ShageeshanT/easycliq/components/MAX485-TTL-to-RS485-Module_front.jpeg

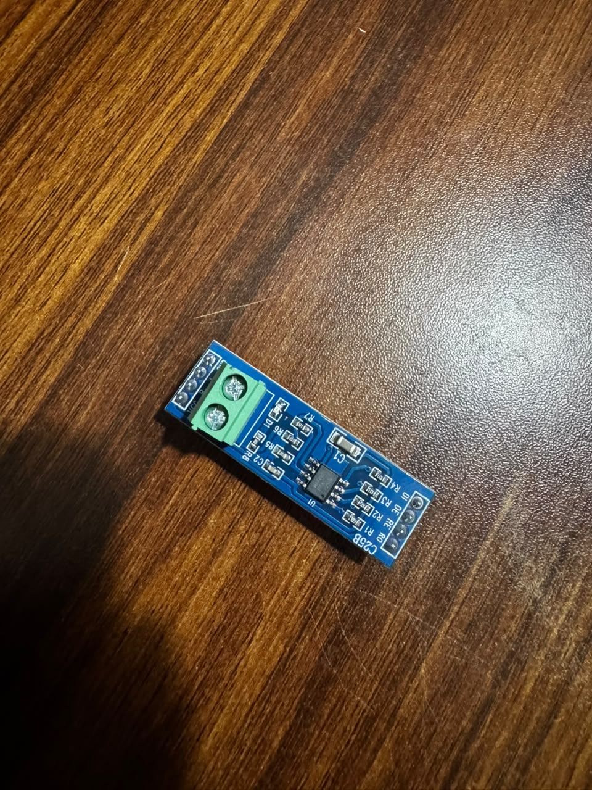
components/MAX485-TTL-to-RS485-Module_front.jpeg
