ShageeshanT/easycliq/components/Micro-Limit-Switch-Roller-Lever-x2_and_Screw-Terminal-5.08mm-2pin-x2.jpeg

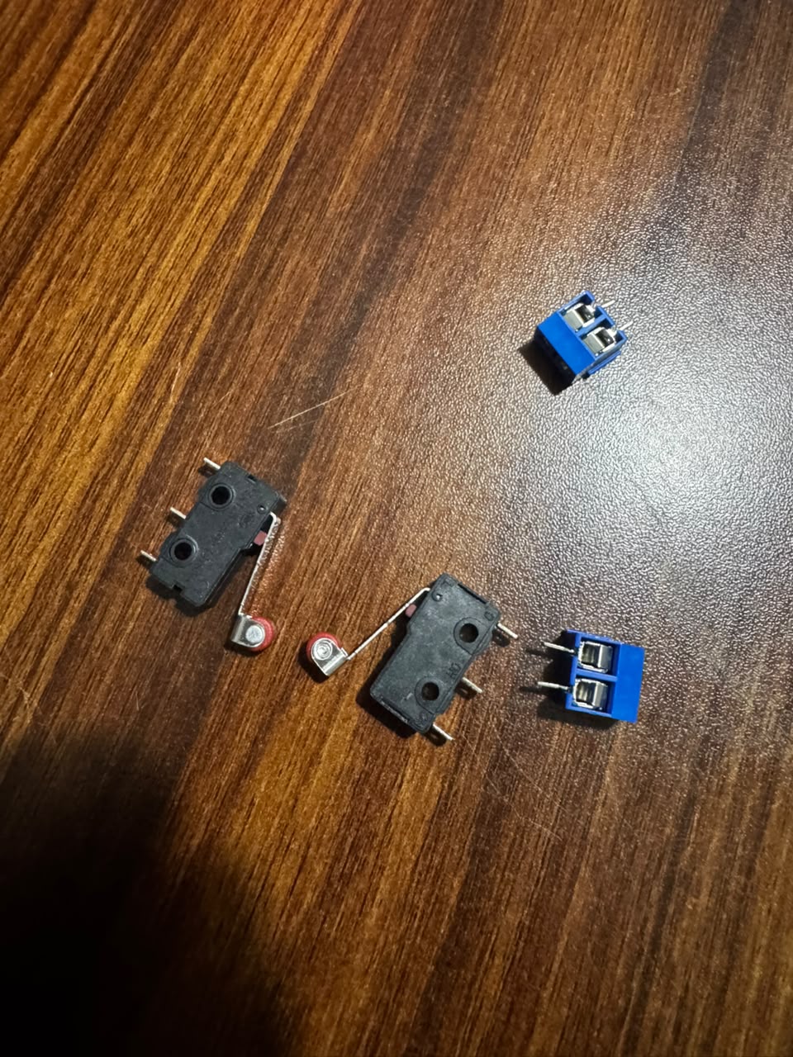
components/Micro-Limit-Switch-Roller-Lever-x2_and_Screw-Terminal-5.08mm-2pin-x2.jpeg
