ShageeshanT/easycliq/EasyCliq-Buy-List.pdf

E A S Y C L I Q · S T A G E 1

# Buy list

Just enough to get all three motors spinning.
Skytronic, Kohuwala · prices from tronic.lk, 24 Sep 2026
ITEM | CODE | QTY | RS
830-point breadboard (MB-102) | TA0036 | 1 | 250
100 µF 50 V electrolytic capacitor | CA0122 | 5 | 25
4.7 kΩ resistor pack (~40 pcs) | RP0043 | 1 | 50
10 kΩ resistor pack (~40 pcs) | RP0047 | 1 | 50
Total | | | 375

ONLY IF YOU DON'T ALREADY HAVE ONE
DT830D multimeter | TA0077 | 1 | 830
Computer power cord 13A | TA1235 | 1 | 720

Everything else waits until the three motors spin and the build is verified.
