ShageeshanT/easycliq/components/AHT20-AM2301B-Temp-Humidity-Sensor_box.jpeg

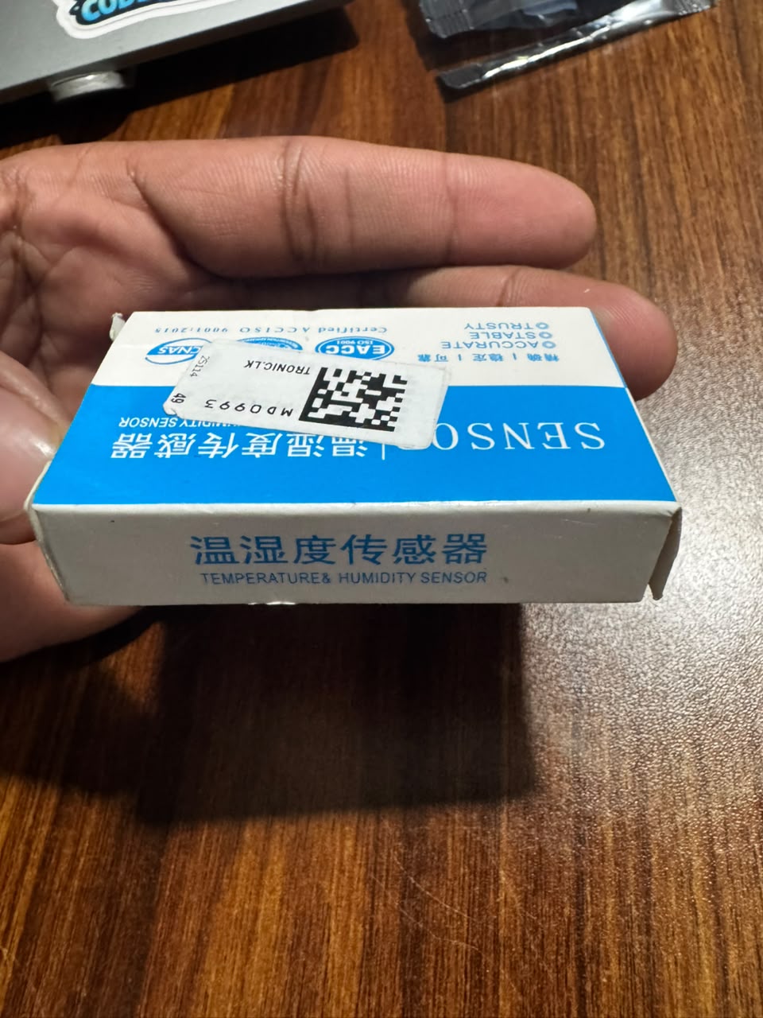
components/AHT20-AM2301B-Temp-Humidity-Sensor_box.jpeg
