ShageeshanT/easycliq/components/Breadboard-400-Tiepoint_packaged.jpeg

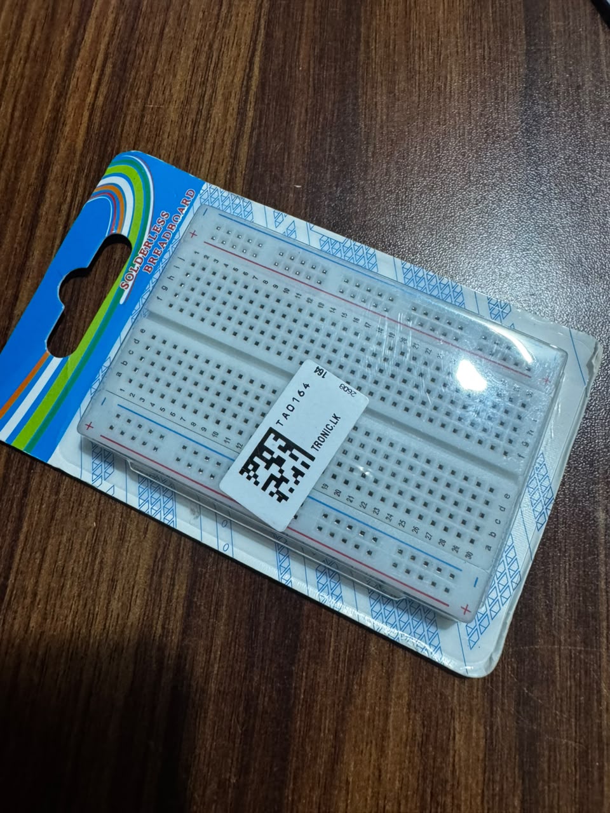
components/Breadboard-400-Tiepoint_packaged.jpeg
