ShageeshanT/easycliq/components/DRV8825-Stepper-Driver_back-pin-labels_with-heatsink.jpeg

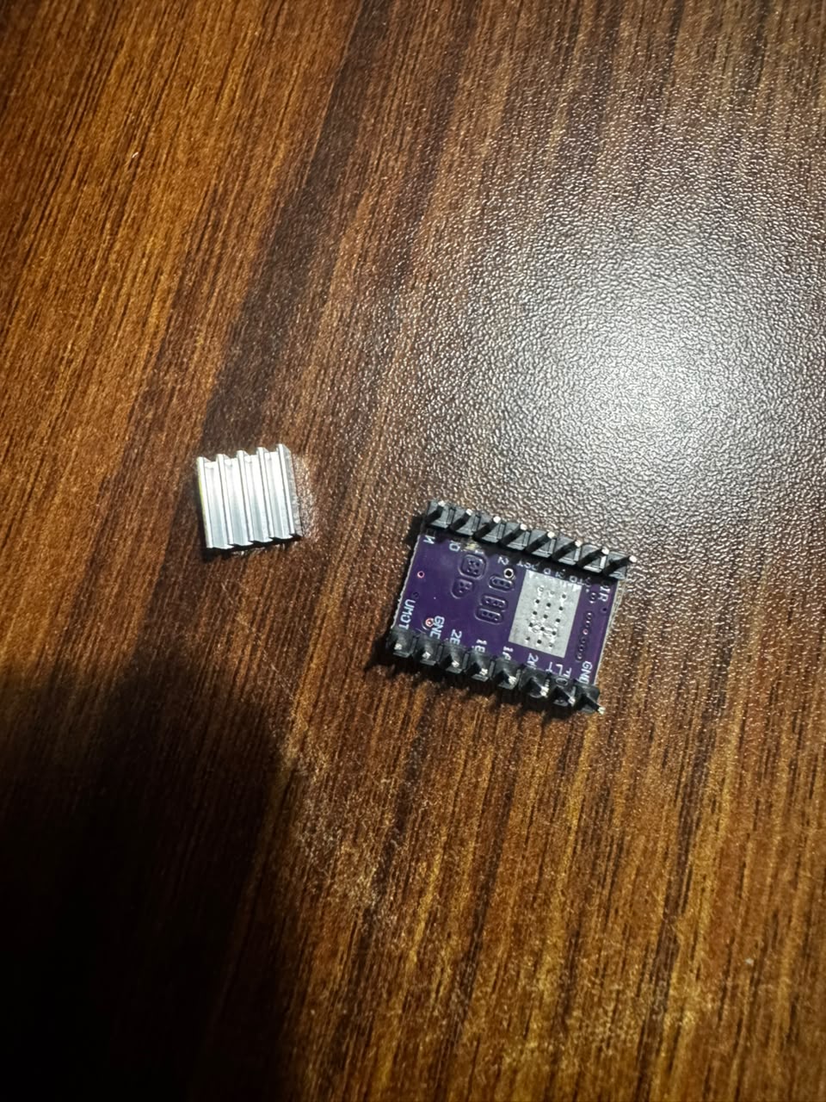
components/DRV8825-Stepper-Driver_back-pin-labels_with-heatsink.jpeg
