ShageeshanT/easycliq/components/DRV8825-Stepper-Driver_front-chip-side_with-heatsink.jpeg

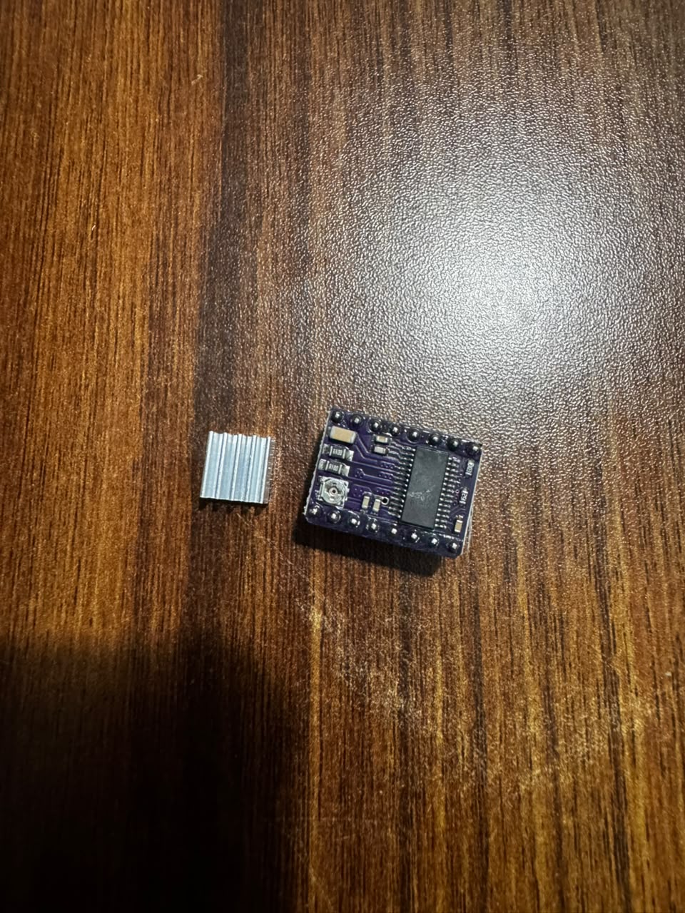
components/DRV8825-Stepper-Driver_front-chip-side_with-heatsink.jpeg
