ShageeshanT/easycliq/components/ESP32-DevKit-30pin-CP2102_front_2.jpeg

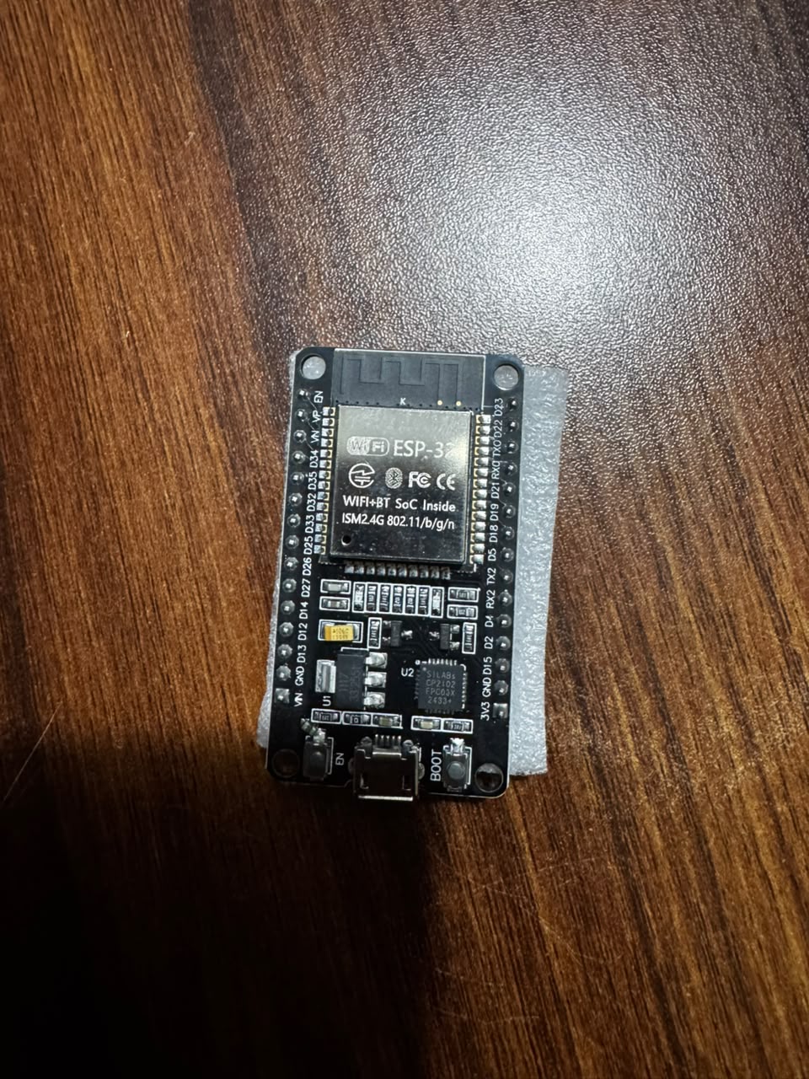
components/ESP32-DevKit-30pin-CP2102_front_2.jpeg
