ShageeshanT/easycliq/components/IRF520-MOSFET-Module-Keyes_front.jpeg

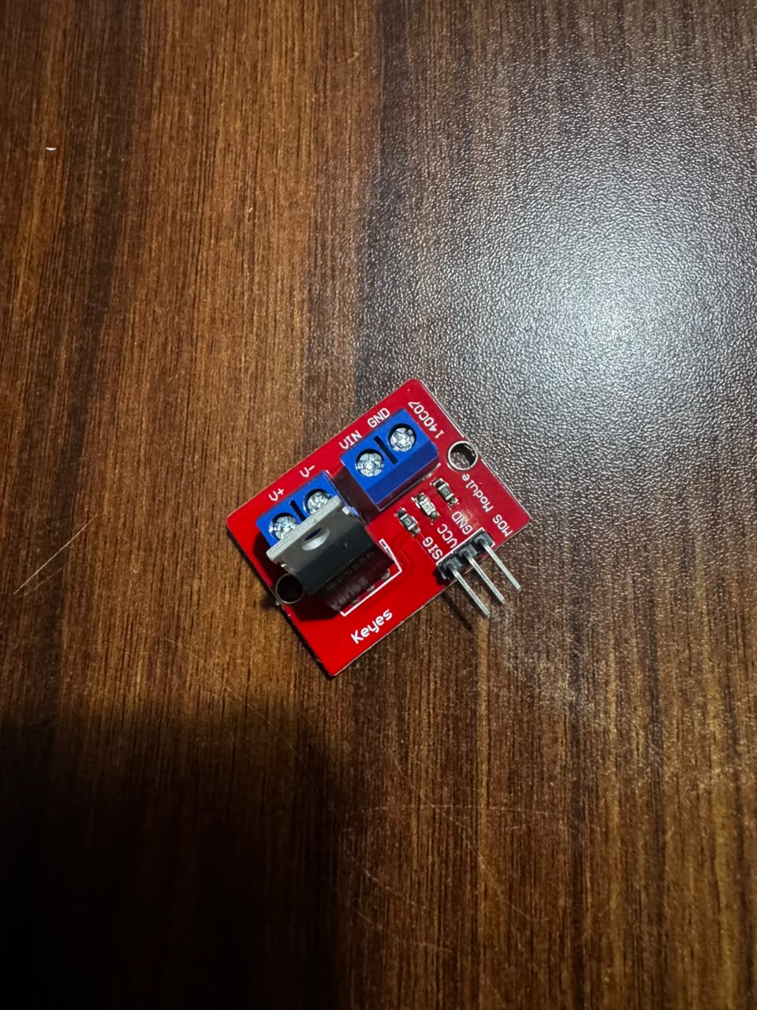
components/IRF520-MOSFET-Module-Keyes_front.jpeg
