ShageeshanT/easycliq/components/LM2596-Buck-Converter-HW-411_back.jpeg

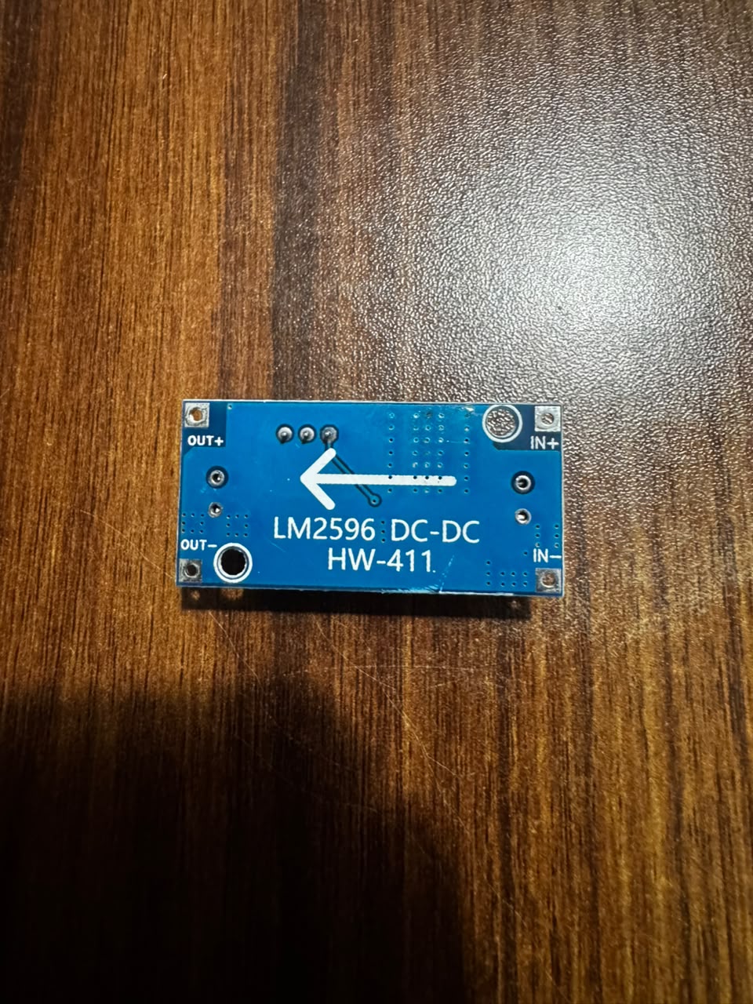
components/LM2596-Buck-Converter-HW-411_back.jpeg
