ShageeshanT/easycliq/components/LM2596-Buck-Converter-HW-411_front.jpeg

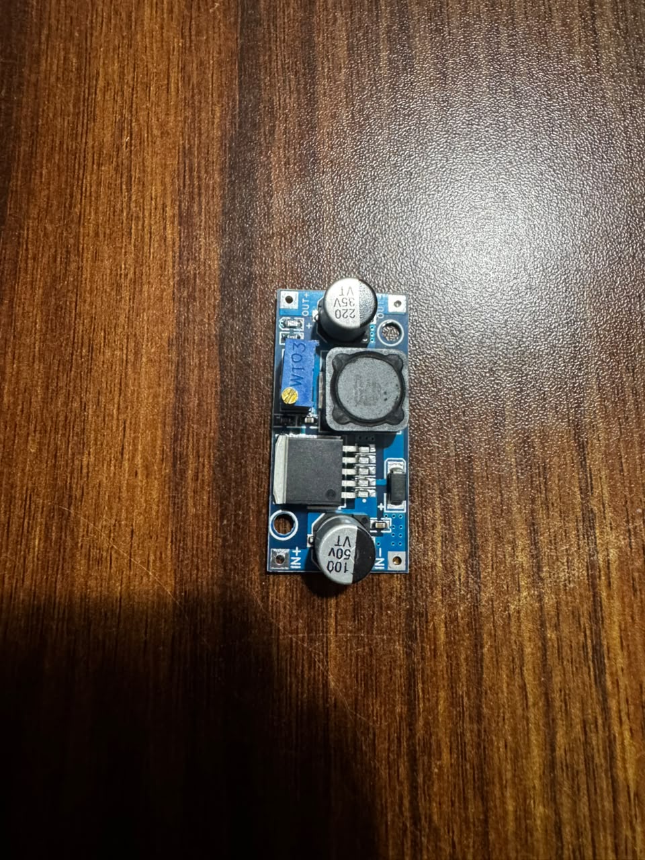
components/LM2596-Buck-Converter-HW-411_front.jpeg
