ShageeshanT/easycliq/components/MAX485-TTL-to-RS485-Module_back.jpeg

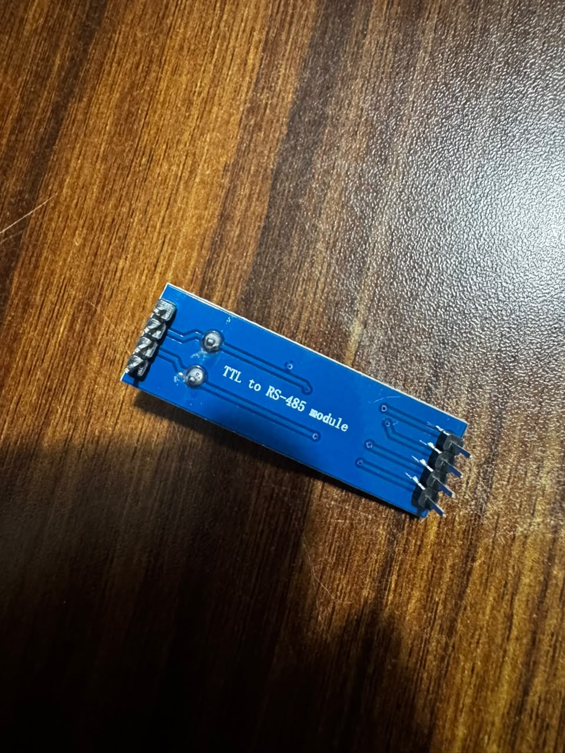
components/MAX485-TTL-to-RS485-Module_back.jpeg
