ShageeshanT/easycliq/components/NEMA17-Stepper-Motor-Usongshine-17HS4401_with-cable.jpeg

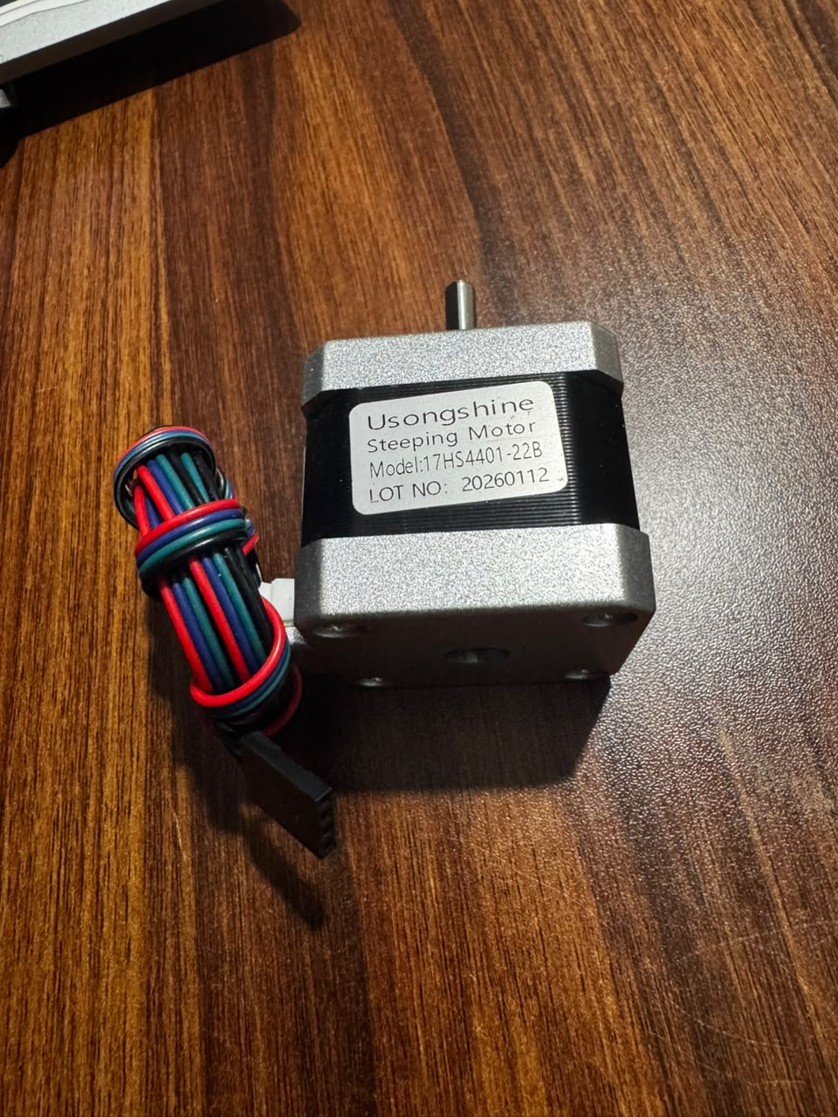
components/NEMA17-Stepper-Motor-Usongshine-17HS4401_with-cable.jpeg
