ShageeshanT/easycliq/components/SMPS-24V-5A-S-120-24_box-label.jpeg

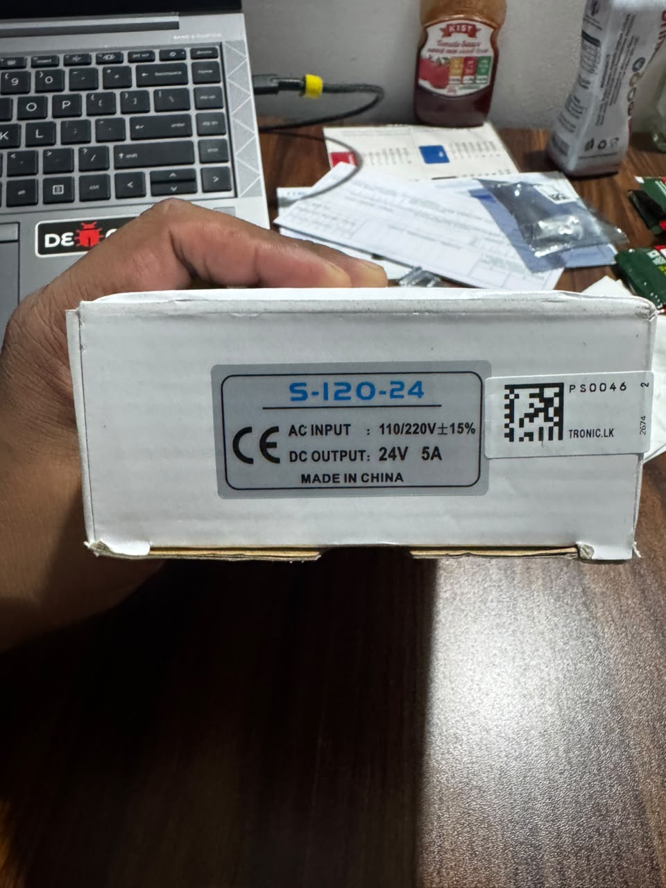
components/SMPS-24V-5A-S-120-24_box-label.jpeg
