ShageeshanT/easycliq/components/SMPS-24V-5A-S-120-24_unit-top.jpeg

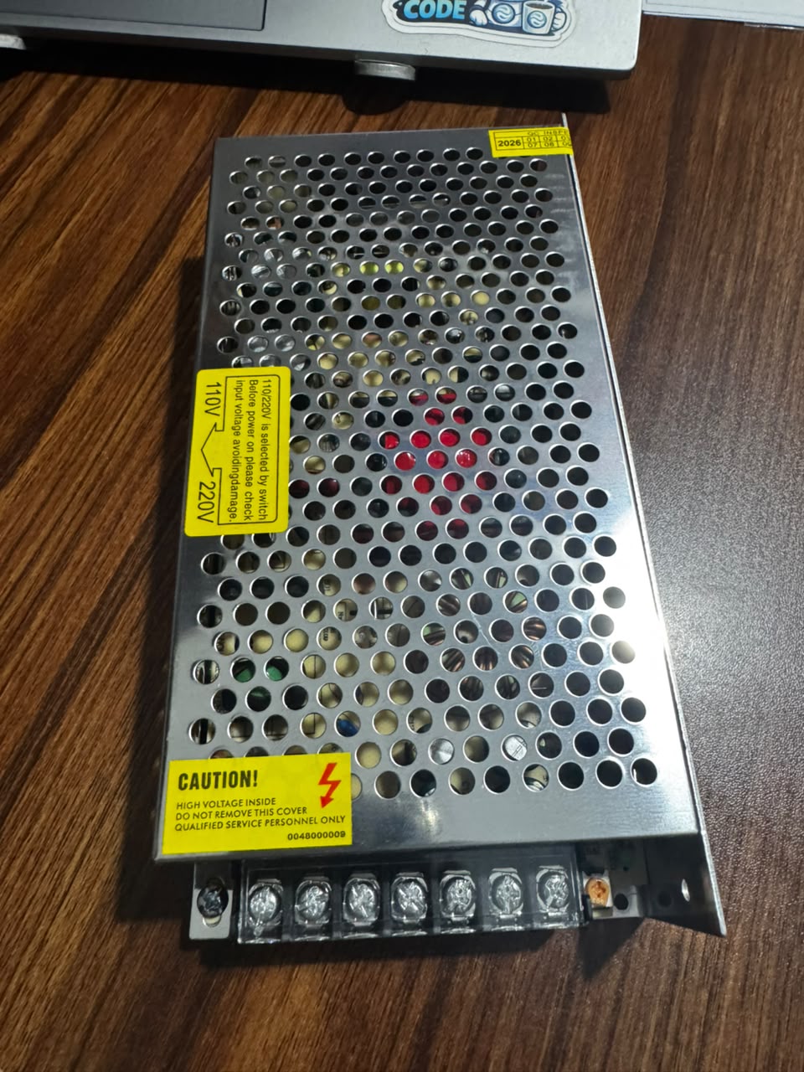
components/SMPS-24V-5A-S-120-24_unit-top.jpeg
